svenschwermer/filament-clock/pcb/segment/filament-clock.kicad_pcb

## KiCad design pcb/segment/filament-clock.kicad_pcb (2020-12-18)

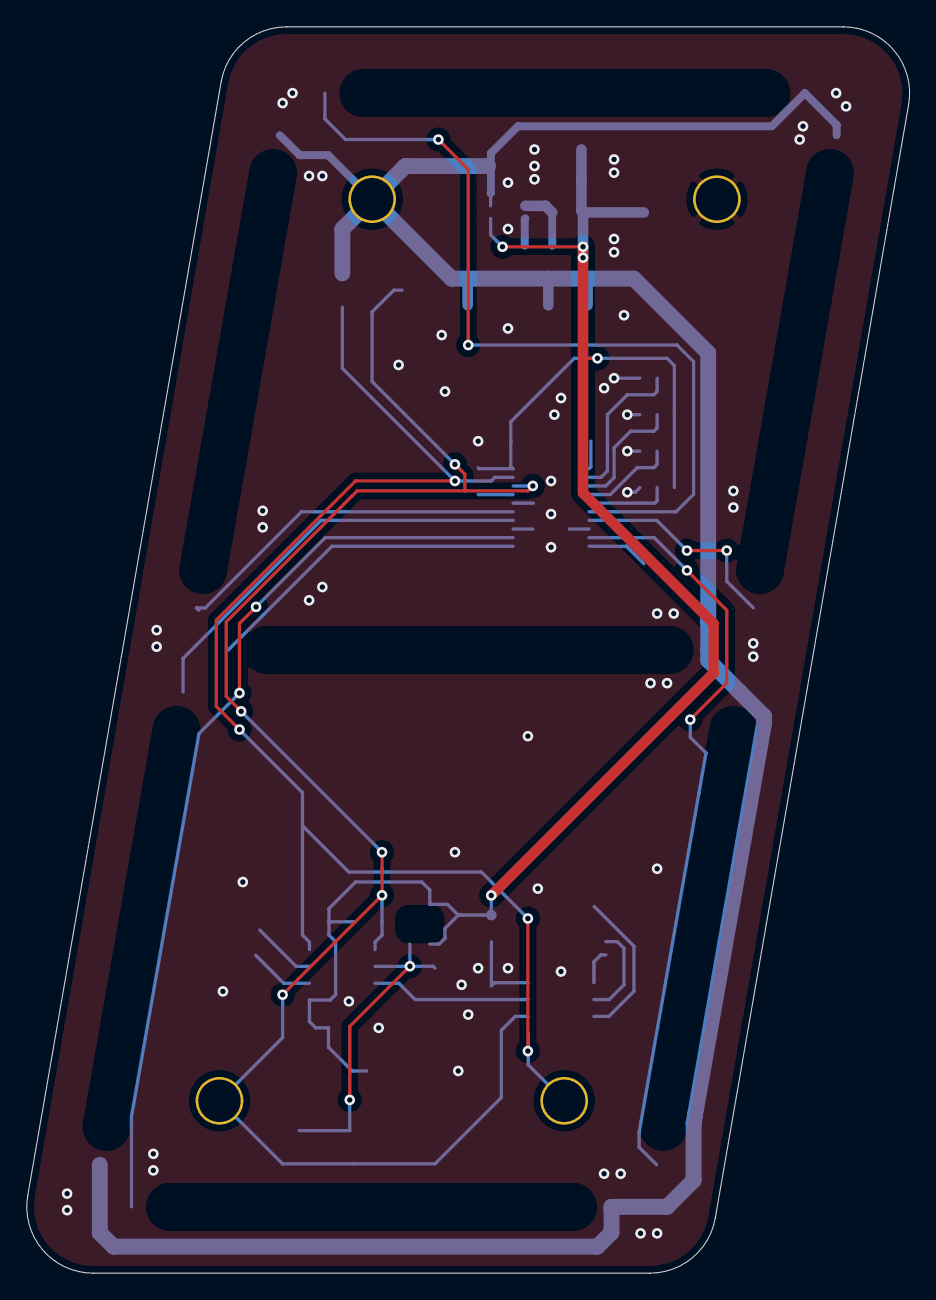
[picture p1: board filament-clock.kicad_pcb from above]

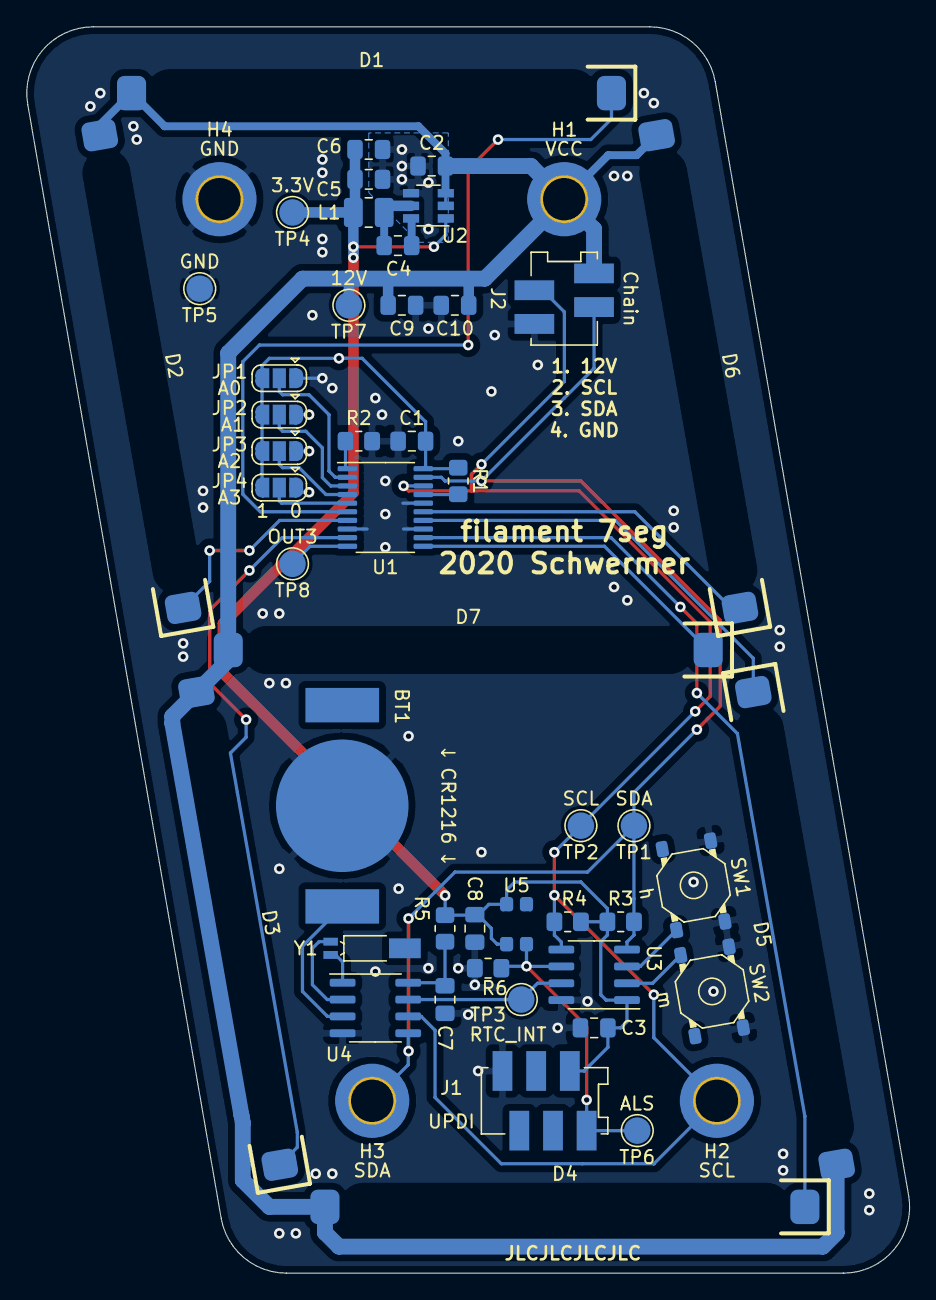
[picture p2: board filament-clock.kicad_pcb from below]

Board: 2 copper layers, 66.6 x 94.0 mm, 51 parts (51 on the bottom side), 29 nets.

Parts:
BT1: CR1216; BC-2017
C1, C3, C4, C8: 100n; C_0805_2012Metric_Pad1.18x1.45mm_HandSolder
C2: 10µ; C_0805_2012Metric_Pad1.18x1.45mm_HandSolder
C5, C6: 22µ; C_0805_2012Metric_Pad1.18x1.45mm_HandSolder
C7: 3.3µ; C_0805_2012Metric_Pad1.18x1.45mm_HandSolder
C9, C10: C; C_0805_2012Metric_Pad1.18x1.45mm_HandSolder
D1, D2, D3, D4, D5, D6, D7: LED; filament-led
H1: VCC; MountingHole_3.2mm_M3_DIN965_Pad_TopOnly
H2: SCL; MountingHole_3.2mm_M3_DIN965_Pad_TopOnly
H3: SDA; MountingHole_3.2mm_M3_DIN965_Pad_TopOnly
H4: GND; MountingHole_3.2mm_M3_DIN965_Pad_TopOnly
J1: UPDI; ConnectorMicromatch-6
J2: Chain; ConnectorMicromatch-4
JP1: A0; SolderJumper-3_P1.3mm_Open_RoundedPad1.0x1.5mm
JP2: A1; SolderJumper-3_P1.3mm_Open_RoundedPad1.0x1.5mm
JP3: A2; SolderJumper-3_P1.3mm_Open_RoundedPad1.0x1.5mm
JP4: A3; SolderJumper-3_P1.3mm_Open_RoundedPad1.0x1.5mm
L1: 4.7µ; L_1008_2520Metric_Pad1.43x2.20mm_HandSolder
R1: 10k; R_0805_2012Metric_Pad1.20x1.40mm_HandSolder
R2: 3.9k; R_0805_2012Metric_Pad1.20x1.40mm_HandSolder
R3, R4: 4.7k; R_0805_2012Metric_Pad1.20x1.40mm_HandSolder
R5: 1k; R_0805_2012Metric_Pad1.20x1.40mm_HandSolder
R6: 5k; R_0805_2012Metric_Pad1.20x1.40mm_HandSolder
SW1: h; pts526
SW2: m; pts526
TP1: SDA; TestPoint_Pad_D2.0mm
TP2: SCL; TestPoint_Pad_D2.0mm
TP3: RTC_INT; TestPoint_Pad_D2.0mm
TP4: 3.3V; TestPoint_Pad_D2.0mm
TP5: GND; TestPoint_Pad_D2.0mm
TP6: ALS; TestPoint_Pad_D2.0mm
TP7: 12V; TestPoint_Pad_D2.0mm
TP8: OUT3; TestPoint_Pad_D2.0mm
U1: TLC59108xPW; TSSOP-20_4.4x6.5mm_P0.65mm
U2: AP63203WU; TSOT-23-6
U3: ATtiny412-SS; SOIC-8_3.9x4.9mm_P1.27mm
U4: PCF8523T; SOIC-8_3.9x4.9mm_P1.27mm
U5: apds-9006; chipled-4
Y1: 32.768kHz; Crystal_SMD_MicroCrystal_MS3V-T1R

Connections:
+3V3: C1.1, C3.2, C5.1, C6.1, C8.1, J1.2, JP1.3, JP2.3, JP3.3, JP4.3, L1.2, R1.1, R3.1, R4.1, R5.1, TP4.1, U1.20, U2.1, U3.1, U5.2, U5.3
+12V: C2.1, C9.1, C10.1, D1.2, D2.2, D3.2, D4.2, D5.2, D6.2, D7.2, H1.1, J2.1, TP7.1, U2.2, U2.3
GND: BT1.2, C1.2, C2.2, C3.1, C5.2, C6.2, C7.1, C8.2, C9.2, C10.2, H4.1, J1.6, J2.4, JP1.1, JP2.1, JP3.1, JP4.1, R2.2, R6.2, SW1.3, SW1.4, SW2.3, SW2.4, TP5.1, U1.8, U1.13, U1.16, U2.4, U3.8, U4.4
unnamed: BT1.1, U4.3
unnamed: C4.1, L1.1, U2.5
unnamed: C4.2, U2.6
unnamed: C7.2, R5.2, U4.8
unnamed: D1.1, U1.6
unnamed: D2.1, U1.7
unnamed: D3.1, U1.9
unnamed: D4.1, U1.12
unnamed: D5.1, U1.14
unnamed: D6.1, U1.15
unnamed: D7.1, U1.11
unnamed: J1.1, R6.1, TP6.1, U3.6, U5.1
unnamed: JP1.2, U1.2
unnamed: JP2.2, U1.3
unnamed: JP3.2, U1.4
unnamed: JP4.2, U1.5
unnamed: R1.2, U1.17
unnamed: R2.1, U1.1
unnamed: SW1.1, U3.3
unnamed: SW2.2, U3.2
unnamed: TP8.1, U1.10
unnamed: U4.1, Y1.1
unnamed: U4.2, Y1.2
RTC_INT: TP3.1, U3.7, U4.7
SCL: H2.1, J2.2, R4.2, TP2.1, U1.18, U3.5, U4.6
SDA: H3.1, J2.3, R3.2, TP1.1, U1.19, U3.4, U4.5
