svenschwermer/filament-clock/pcb/separator/separator.kicad_pcb

## KiCad design pcb/separator/separator.kicad_pcb (2020-12-18)

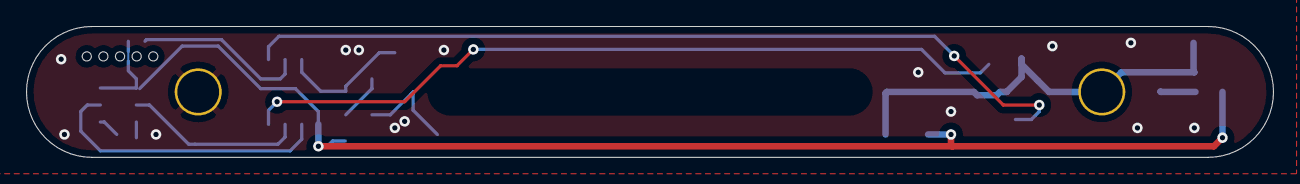
[picture p3: board separator.kicad_pcb from above]

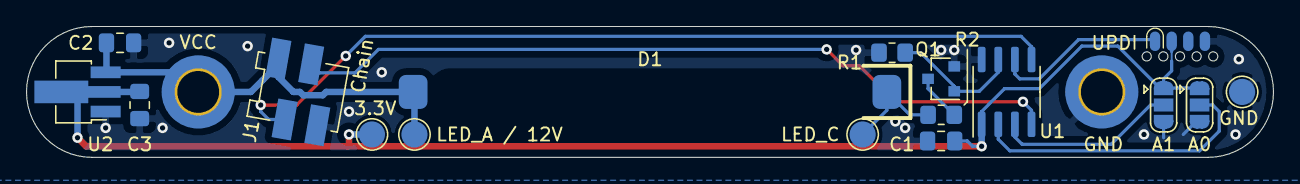
[picture p4: board separator.kicad_pcb from below]

Board: 2 copper layers, 95.3 x 10.0 mm, 19 parts (19 on the bottom side), 11 nets.

Parts:
C1: 100n; C_0805_2012Metric_Pad1.18x1.45mm_HandSolder
C2, C3: 10µ; C_0805_2012Metric_Pad1.18x1.45mm_HandSolder
D1: LED; filament-led
H1: VCC; MountingHole_3.2mm_M3_DIN965_Pad_TopOnly
H2: GND; MountingHole_3.2mm_M3_DIN965_Pad_TopOnly
J1: Chain; ConnectorMicromatch-4
J2: UPDI; SOIC_clipProgSmall_onesided
JP1: A0; SolderJumper-3_P1.3mm_Open_RoundedPad1.0x1.5mm
JP2: A1; SolderJumper-3_P1.3mm_Open_RoundedPad1.0x1.5mm
Q1: 2N7002; SOT-23
R1: 10k; R_0805_2012Metric_Pad1.20x1.40mm_HandSolder
R2: 301; R_0805_2012Metric_Pad1.20x1.40mm_HandSolder
TP1: LED_A / 12V; TestPoint_Pad_D2.0mm
TP2: LED_C; TestPoint_Pad_D2.0mm
TP4: GND; TestPoint_Pad_D2.0mm
TP5: 3.3V; TestPoint_Pad_D2.0mm
U1: ATtiny412-SS; SOIC-8_3.9x4.9mm_P1.27mm
U2: AZ1117-3.3; SOT-89-3_Handsoldering

Connections:
+3V3: C1.2, C3.1, J2.2, JP1.1, JP2.1, TP5.1, U1.1, U2.2
+12V: C2.1, D1.2, H1.1, J1.1, TP1.1, U2.3
A0: JP1.2, U1.2
A1: JP2.2, U1.3
GND: C1.1, C2.2, C3.2, H2.1, J1.4, J2.4, JP1.3, JP2.3, Q1.2, R1.1, TP4.1, U1.8, U2.1
unnamed: D1.1, R2.1, TP2.1
unnamed: Q1.1, R1.2, U1.7
unnamed: Q1.3, R2.2
SCL: J1.2, U1.5
SDA: J1.3, U1.4
UPDI: J2.1, U1.6
