svenschwermer/filament-clock/(commit log)

2020-12-10 PCB Rev 1
    [filament-clock.kicad_pcb, filament-clock.sch, filament-led.FCStd, filament-led.step]
2020-12-13 Fix PCB
    [filament-clock.kicad_pcb, filament-clock.sch]
2020-12-13 Add firmware
    We can talk to the LED driver and read the seconds register from the
    RTC. This all works so far.
2020-12-13 Add i2cdriver test script
2020-12-13 Move kicad files into pcb folder
    [filament-clock.kicad_pcb, filament-clock.sch, filament-led.FCStd, filament-led.step]
2020-12-13 Add SOICbite footprints
2020-12-18 Fixup PCB
    [filament-clock.kicad_pcb]
2020-12-18 Add separator PCB
    Dimensions should be correct.
    [separator.kicad_pcb, separator.sch]
2021-02-21 fw: Some parts working
    Problems:
    1. 2nd digit doesn't work when RTC is read
    2. Separator doesn't blink
    [main.c, pcf8523.c, pcf8523.h, tlc59108.c, tlc59108.h, twi.c, twi.h]
2021-02-21 fw: Not working parts resolved
    [bcd.c, main.c, pcf8523.h, sep.c, tlc59108.c, tlc59108.h]
2021-02-21 Restructure repo
    [filament-clock.kicad_pcb, filament-clock.sch, separator.kicad_pcb, separator.sch]
2021-02-21 fw: RTC second interrupt
